DavidJVitale/AutoGoni/ArduinoSrc/Lab2_Blinky/Lab2_Blinky.c

/*
 * Lab2_Blinky.c
 *
 * Created: 9/27/2016 1:32:24 PM
 *  Author: 2541vitaled
 */ 


#include <avr/io.h>

int main(void)
{
    while(1)
    {
        //TODO:: Please write your application code 
    }
}
