DavidJVitale/AutoGoni/ArduinoSrc/Lab2_Blinky/ucos_ii.c

/*
*********************************************************************************************************
*                                                uC/OS-II
*                                          The Real-Time Kernel
*
*                        (c) Copyright 1992-1998, Jean J. Labrosse, Plantation, FL
*                                           All Rights Reserved
*
*                                                  V2.00
*
* File : uCOS_II.C
* By   : Jean J. Labrosse
*********************************************************************************************************
*/

#define  OS_GLOBALS                           /* Declare GLOBAL variables                              */
#include "includes.h"


#define  OS_MASTER_FILE                       /* Prevent the following files from including includes.h */
#include "src_NEW/os_core.c"

#include "src_NEW/os_mbox.c"
//#include "os_mem.c"

#include "src_NEW/os_q.c"
#include "src_NEW/os_sem.c"
#include "src_NEW/os_task.c"
#include "src_NEW/os_time.c"
