DavidJVitale/AutoGoni/(commit log)

2016-11-03 code that works on the arduino mini
2016-11-15 rotary encoder semi-functional debug output of angle information
2016-12-02 Paul's rotary encoder code workinggit diffgit diff
2016-12-02 fixed with working strings to output useful information to the screen
    [main.c, os_cpu_c.c]
2016-12-02 What appears to be full functional error state printing with (maybe) functional degree output printing -David
    [main.c]
2016-12-06 v0.1 of autogoni record saving information just incase we can no longer flash to our board
    [main.c]
